SFXShannon/alexa-button-box/base.stl

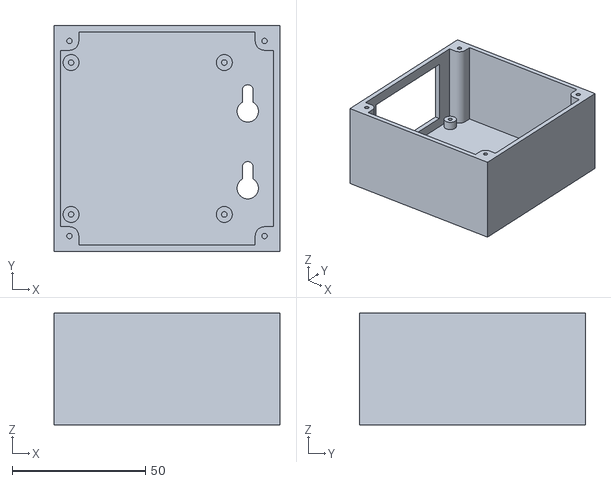
[picture p2: CAD file, 2026-10-14]
base.stl
84.8 x 84.8 x 42.0
