SFXShannon/alexa-button-box/lid.stl

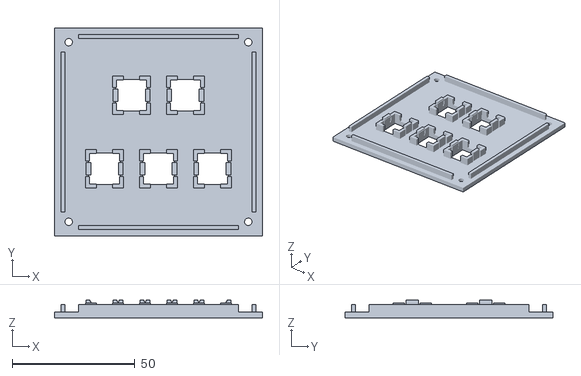
[picture p3: CAD file, 2026-10-14]
lid.stl
84.8 x 84.8 x 7.30
