SFXShannon/alexa-button-box/(commit log)

2026-10-13 Alexa 3-button wall box: case STLs, generator script, ESP8266 sketch
    Claude-Session: https://claude.ai/code/session_01BjdUewWy9iqikroi51dazT
    [base.stl, lid.stl]
2026-10-13 Add Lights On / Lights Off buttons (5-button layout)
    Case widened to two rows: plug on/off/cycle on top, lights on/off below
    with sun and moon symbols. Sketch adds D1/D2 triggers; README updated.
    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
    [base.stl, lid.stl]
2026-10-13 Fit case to GPIO 1-into-2 breakout board
    Base now holds the 63.5 x 63 mm expansion board on corner pads with
    L-shaped locating fences, adds a 50 mm access window for the DC jack,
    power switch and USB, and is 8 mm taller. README wiring uses the
    breakout's S/G headers.
    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
    [base.stl]
2026-10-13 Docs: breakout board is powered by micro-USB, not a DC jack
    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
2026-10-13 Add wiring diagram to docs and README
    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
2026-10-13 Control Feit plug locally via home server; lights via Alexa
    Adds server/ (Python, tinytuya): the ESP now calls the home server,
    which switches the Tuya-based Feit plug directly on the LAN and fires
    virtualsmarthome triggers for the Alexa-only lights. Power-cycle delay
    runs on the server and is cancelled by on/off. Includes a Windows
    startup installer, token check, and logging. README rewritten.
    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
2026-10-14 Case v3: snap-in buttons, screw-down board and lid, taller USB window
    - Button holders with corner posts and two snap hooks (no glue)
    - Board on 4 screw standoffs (M2.5), lowered from 7 mm to 4 mm
    - USB window enlarged to fit the NodeMCU's own micro-USB plug + cable
    - Lid fixed with 4 countersunk M2.5 screws into corner bosses
    - Keyholes moved beside the board so wall screws don't clash
    - Removed hairline overlaps that broke STL watertightness
    Board hole spacing (HOLE_DX/HOLE_DY) is an estimate pending measurement.
    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
    [base.stl, lid.stl]
